hedgecrw/CivicAlert/README.md

# CivicAlert
Software, Firmware, and Hardware Design for the CivicAlert Gunshot Locator Project
