hedgecrw/CivicAlert/hardware/design/parts/CP2102N-A02-GQFN28/CP2102N-A02-GQFN28.step

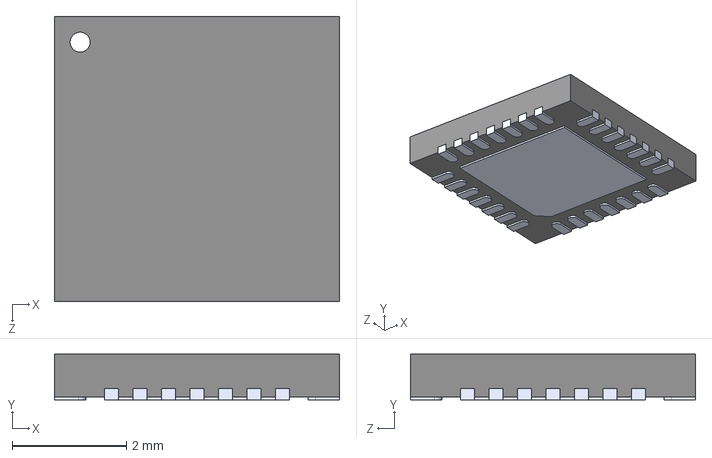
[picture p1: CAD file, 2025-01-08]
hardware/design/parts/CP2102N-A02-GQFN28/CP2102N-A02-GQFN28.step
5.00 x 0.8 x 5.00 mm
