hedgecrw/CivicAlert/hardware/design/parts/ESP32_S3_MINI_1_N8/ESP32-S3-MINI-1-N8.step

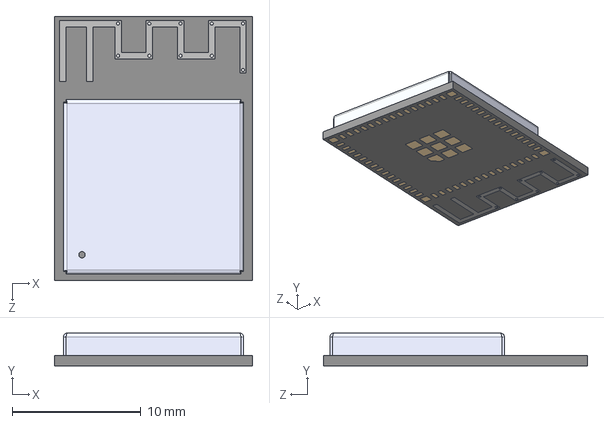
[picture p2: CAD file, 2025-01-08]
hardware/design/parts/ESP32_S3_MINI_1_N8/ESP32-S3-MINI-1-N8.step
15.4 x 2.55 x 20.5 mm
