hedgecrw/CivicAlert/hardware/design/parts/IM73D122V01XTMA1/3D/IM73D122V01XTMA1.stp

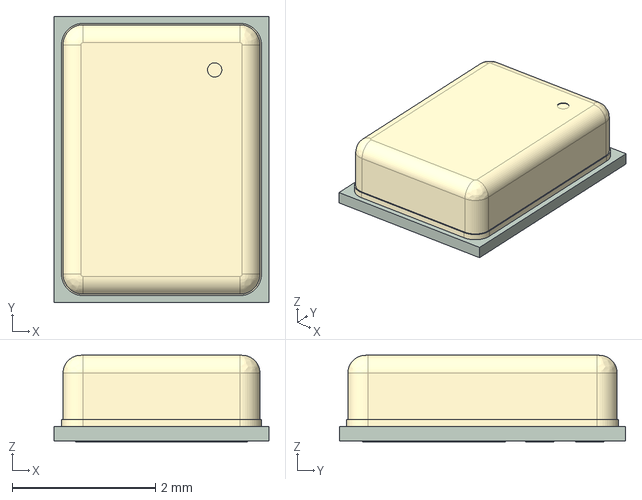
[picture p3: CAD file, 2025-01-08]
hardware/design/parts/IM73D122V01XTMA1/3D/IM73D122V01XTMA1.stp
3.00 x 4.00 x 1.21 mm
