hedgecrw/CivicAlert/hardware/design/parts/LQG15HS47NJ02D/LQG15HS47NJ02D.step

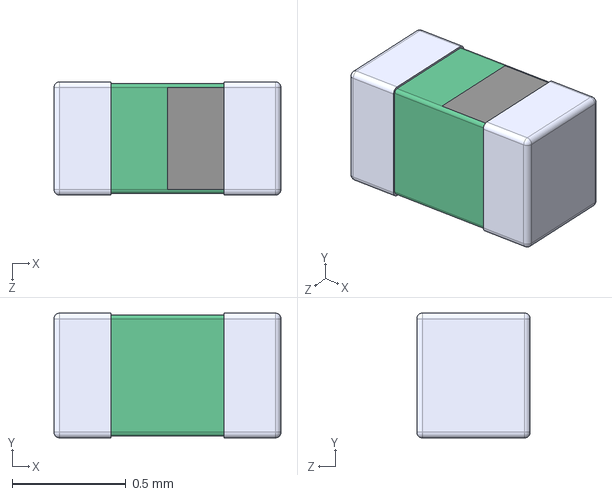
[picture p4: CAD file, 2025-01-08]
hardware/design/parts/LQG15HS47NJ02D/LQG15HS47NJ02D.step
1.00 x 0.55 x 0.5 mm
