hedgecrw/CivicAlert/hardware/design/parts/LTST-C170KRKT/LTST-C170KRKT.step

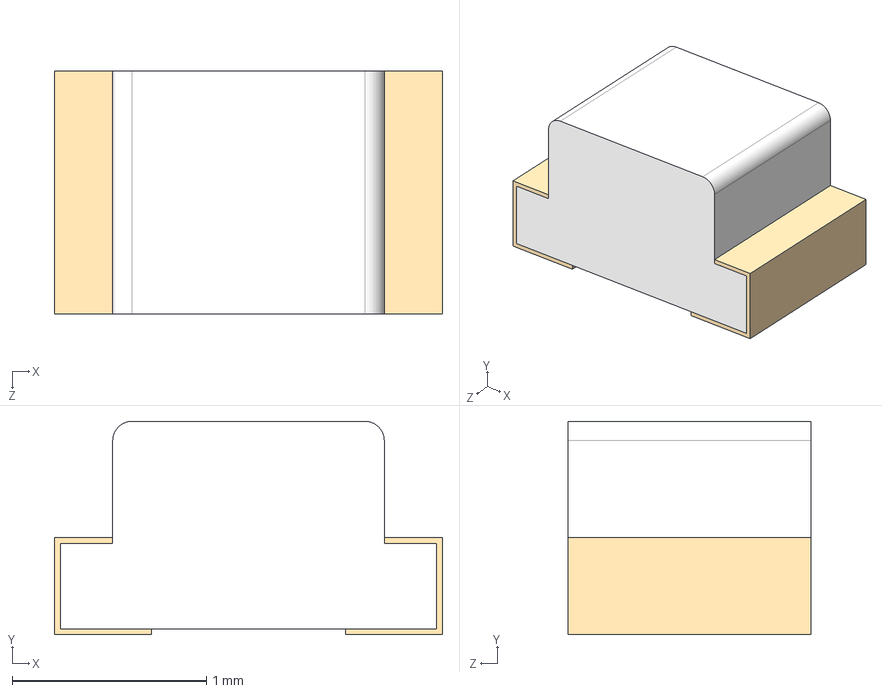
[picture p5: CAD file, 2025-01-08]
hardware/design/parts/LTST-C170KRKT/LTST-C170KRKT.step
2.00 x 1.10 x 1.25 mm
