hedgecrw/CivicAlert/hardware/design/parts/usb/1054440001.step

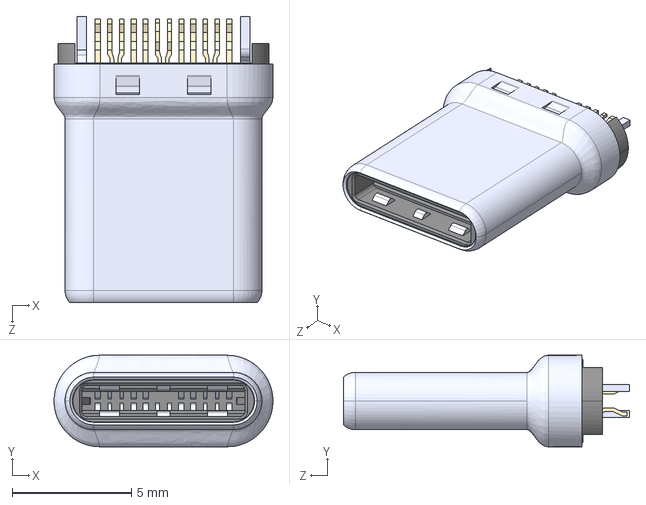
[picture p6: CAD file, 2025-01-08]
hardware/design/parts/usb/1054440001.step
9.18 x 3.84 x 12.0 mm
