hedgecrw/CivicAlert/hardware/design/CivicAlert.kicad_pcb

## KiCad design hardware/design/CivicAlert.kicad_pcb (2025-01-08)

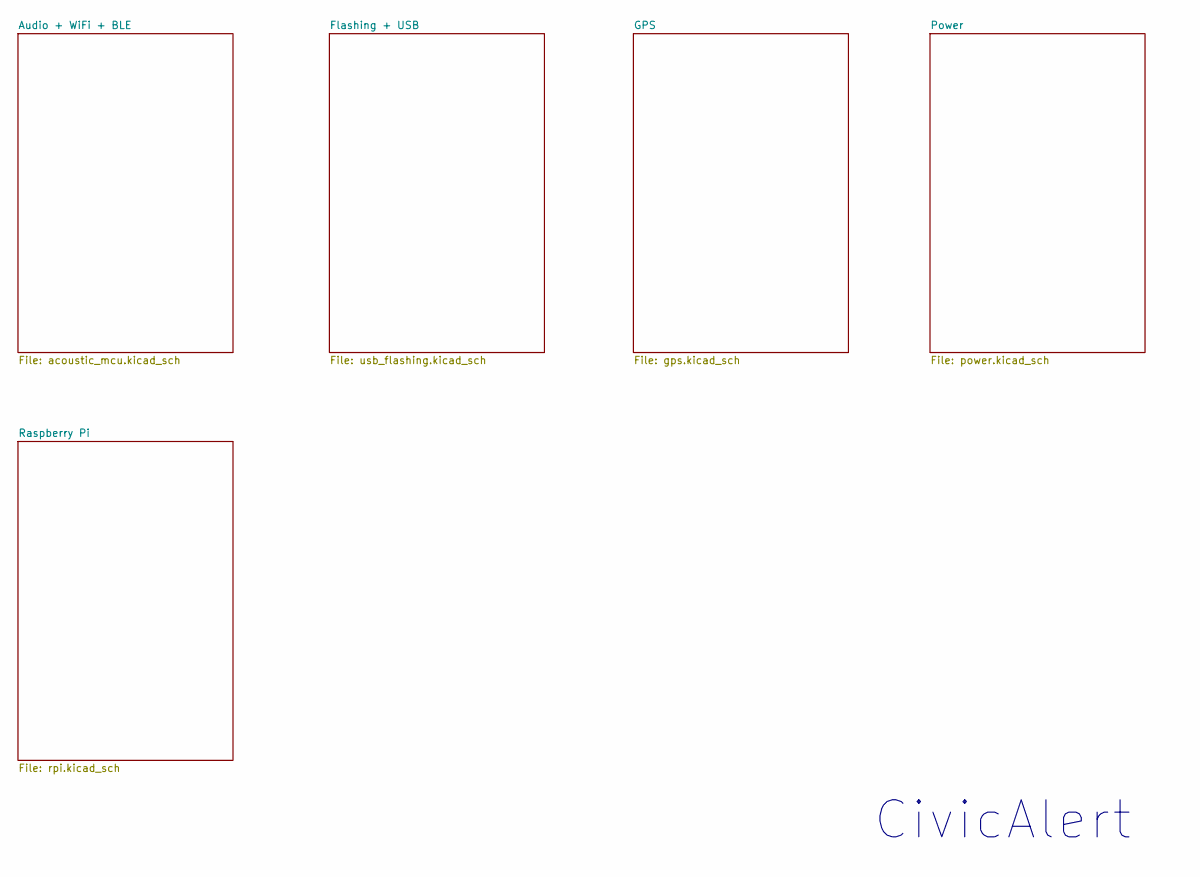
[picture p7: schematic CivicAlert.kicad_sch]

Notes on the sheet:
CivicAlert

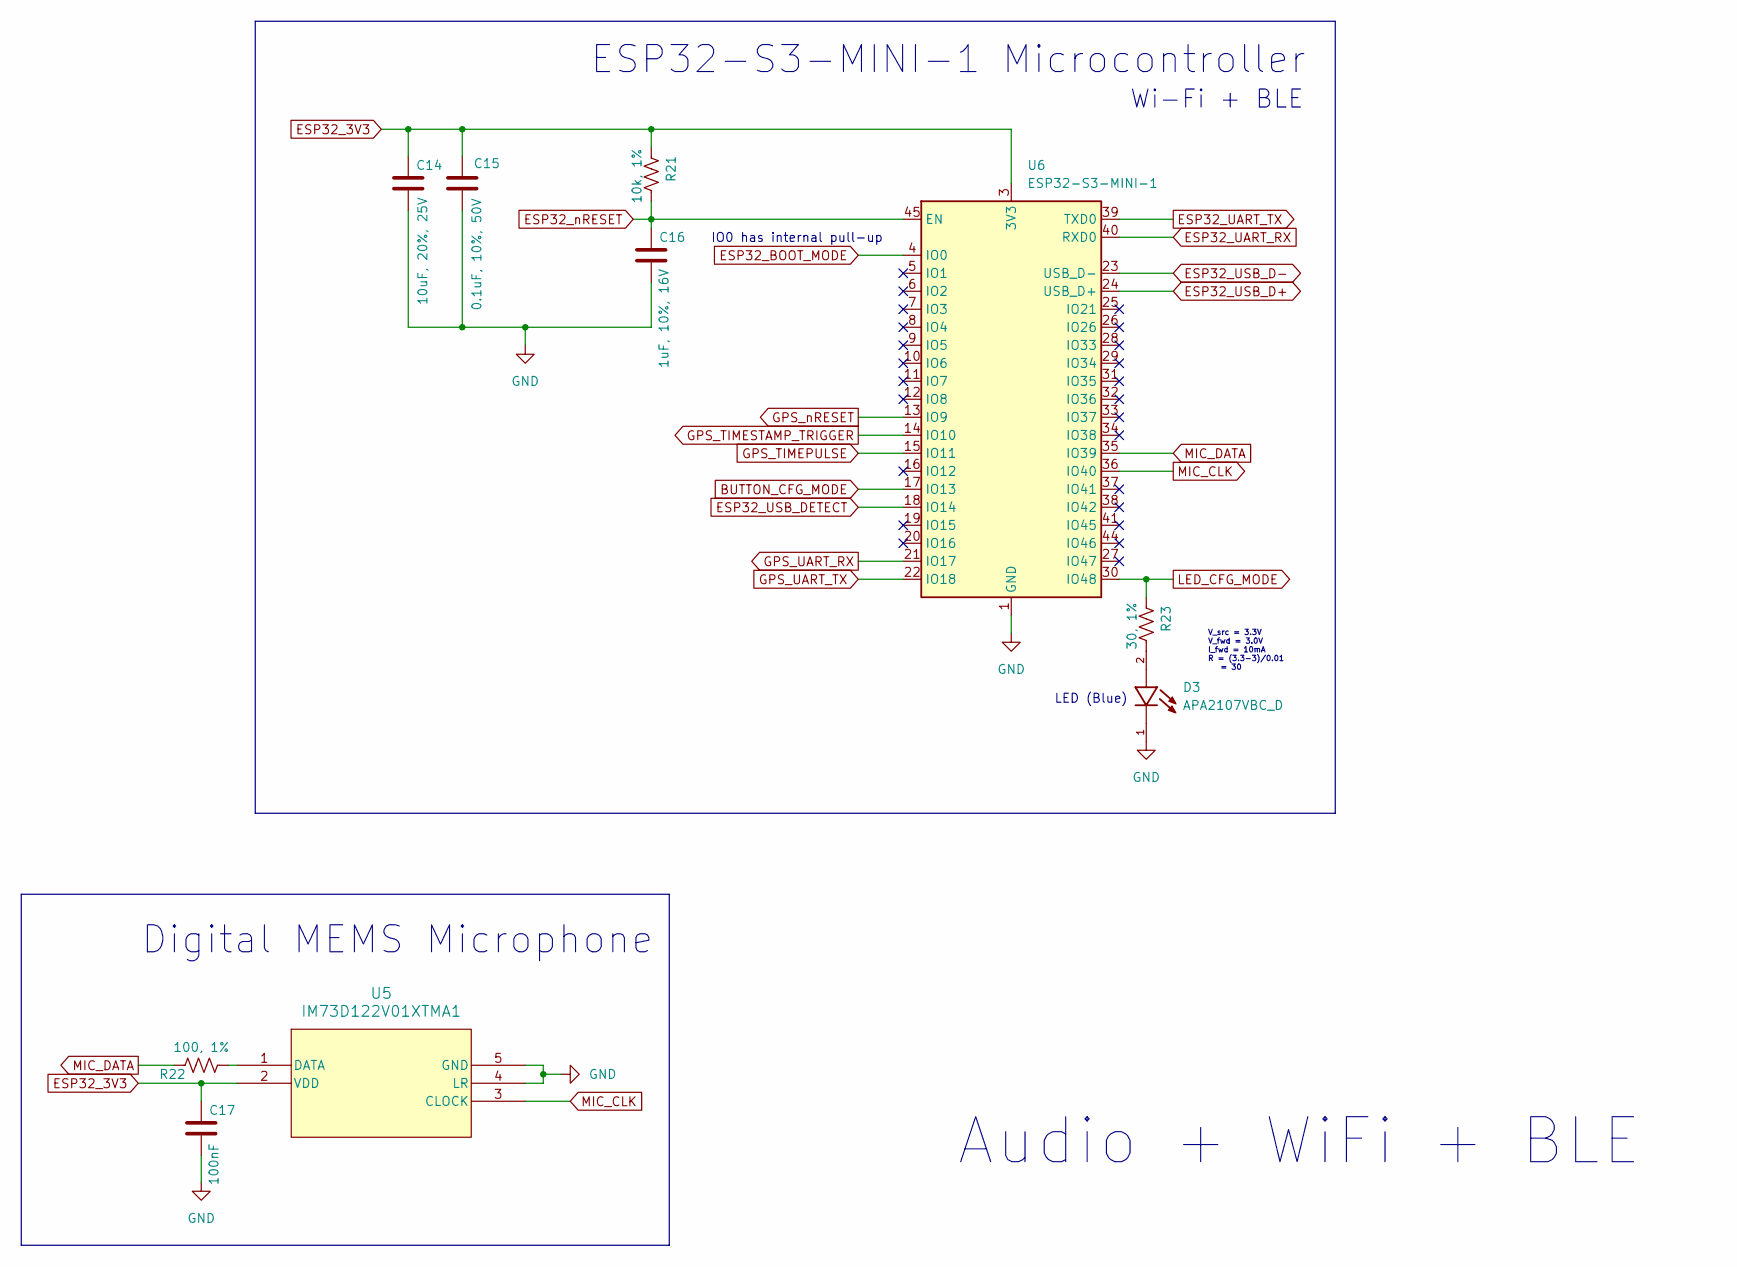
[picture p8: schematic acoustic_mcu.kicad_sch, CivicAlert]

Parts:
C14: 10uF, 20%, 25V; C_0805_2012Metric
C15: 0.1uF, 10%, 50V; C_0805_2012Metric
C16: 1uF, 10%, 16V; C_0805_2012Metric
C17: 100nF; C_0805_2012Metric
D3: APA2107VBC_D; LED_APA2107VBC_D; PARTREV V.5B
R21: 10k, 1%; R_0805_2012Metric
R22: 100, 1%; R_0805_2012Metric
R23: 30, 1%; R_0805_2012Metric
U5: IM73D122V01XTMA1; PG-LLGA-5-2_INF
U6: ESP32-S3-MINI-1; ESP32-S2-MINI-1

Connections:
BUTTON_CFG_MODE: U6.17 (IO13); also elsewhere on the board
ESP32_3V3: C14.1, C15.1, C17.1, R21.1, U5.2 (VDD), U6.3 (3V3); also elsewhere on the board
ESP32_BOOT_MODE: U6.4 (IO0); also elsewhere on the board
ESP32_UART_RX: U6.40 (RXD0); also elsewhere on the board
ESP32_UART_TX: U6.39 (TXD0); also elsewhere on the board
ESP32_USB_D+: U6.24 (USB_D+); also elsewhere on the board
ESP32_USB_D-: U6.23 (USB_D-); also elsewhere on the board
ESP32_USB_DETECT: U6.18 (IO14); also elsewhere on the board
ESP32_nRESET: C16.1, R21.2, U6.45 (EN); also elsewhere on the board
GND: C14.2, C15.2, C16.2, C17.2, D3.1, U5.4 (LR), U5.5 (GND), U6.1 (GND), U6.2 (GND), U6.42 (GND), U6.43 (GND), U6.46 (GND), U6.47 (GND), U6.48 (GND), U6.49 (GND), U6.50 (GND), U6.51 (GND), U6.52 (GND), U6.53 (GND), U6.54 (GND), U6.55 (GND), U6.56 (GND), U6.57 (GND), U6.58 (GND), U6.59 (GND), U6.60 (GND), U6.61 (GND), U6.62 (GND), U6.63 (GND), U6.64 (GND), U6.65 (GND); also elsewhere on the board
GPS_TIMEPULSE: U6.15 (IO11); also elsewhere on the board
GPS_TIMESTAMP_TRIGGER: U6.14 (IO10); also elsewhere on the board
GPS_UART_RX: U6.21 (IO17); also elsewhere on the board
GPS_UART_TX: U6.22 (IO18); also elsewhere on the board
GPS_nRESET: U6.13 (IO9); also elsewhere on the board
LED_CFG_MODE: R23.1, U6.30 (IO48)
MIC_CLK: U5.3 (CLOCK), U6.36 (IO40)
MIC_DATA: R22.2, U6.35 (IO39)
unnamed: D3.2, R23.2
unnamed: R22.1, U5.1 (DATA)

Notes on the sheet:
Digital MEMS Microphone
Audio + WiFi + BLE
ESP32-S3-MINI-1 Microcontroller
Wi-Fi + BLE
LED (Blue)
V_src = 3.3V V_fwd = 3.0V I_fwd = 10mA R = (3.3-3)/0.01 = 30
IO0 has internal pull-up

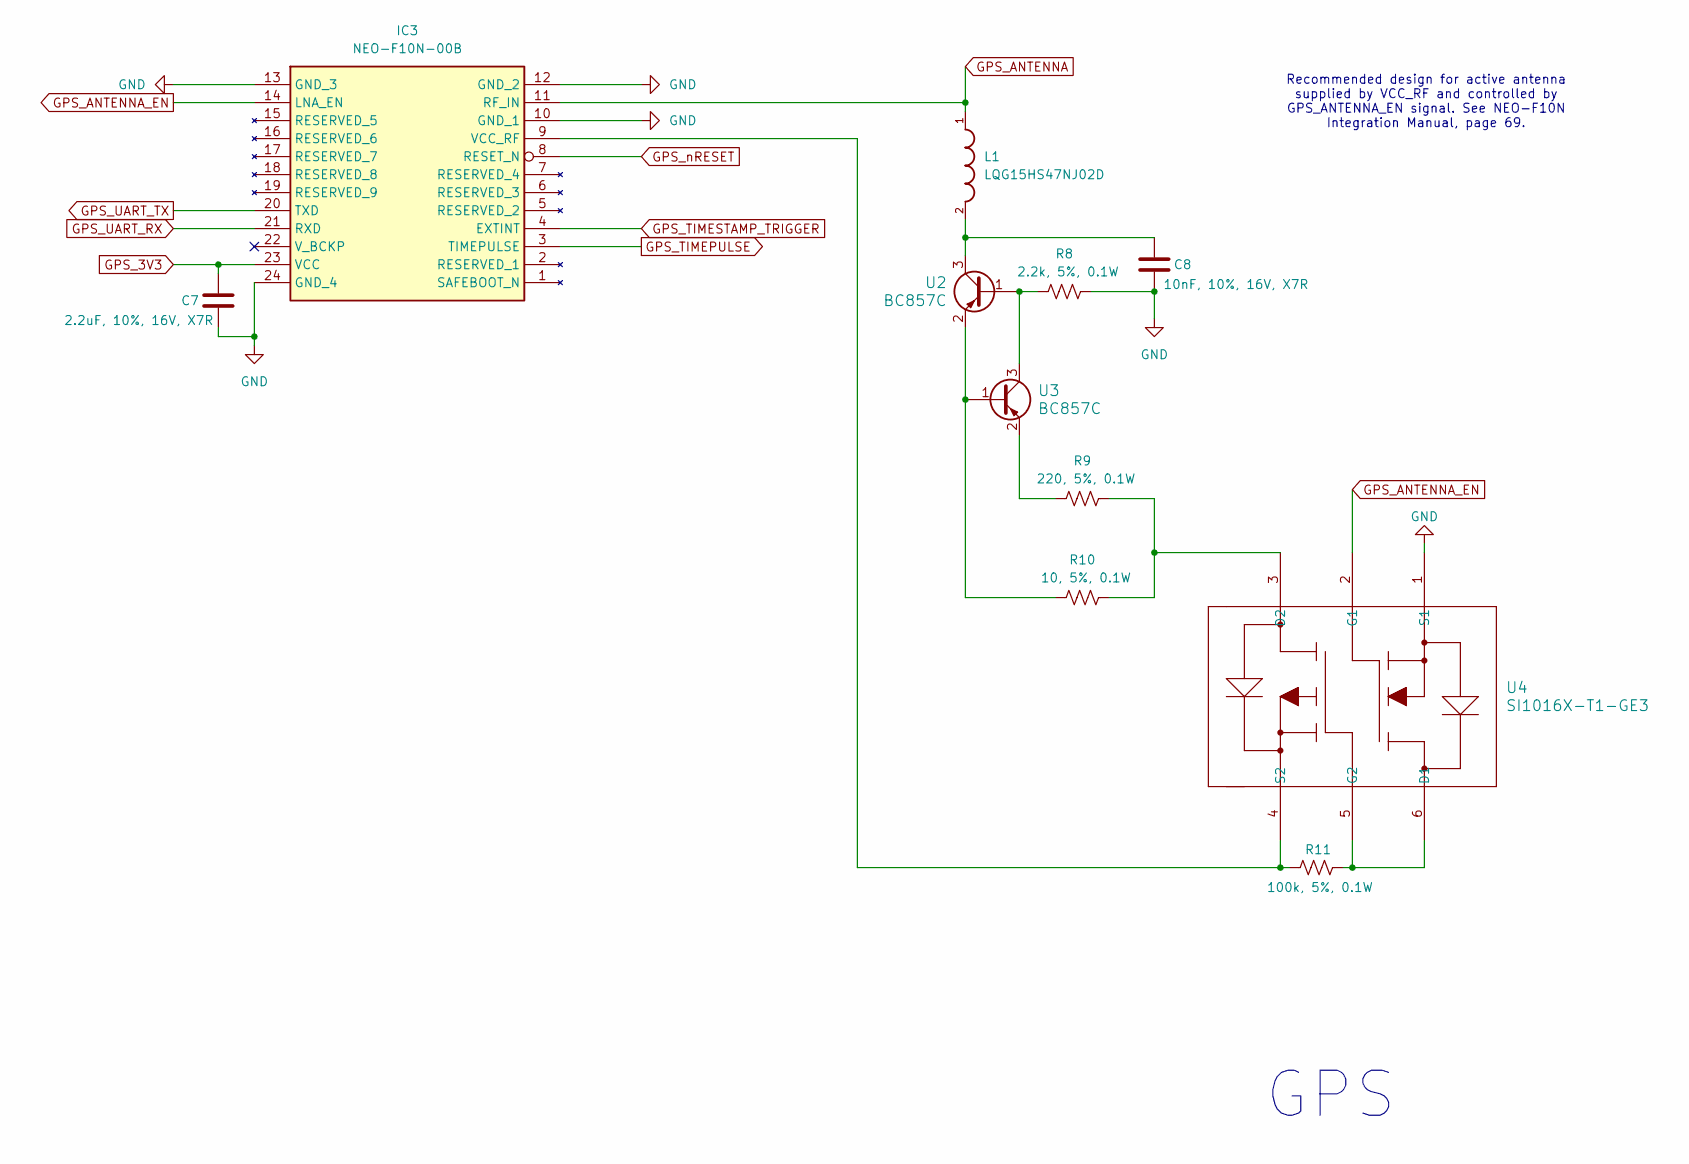
[picture p9: schematic gps.kicad_sch, CivicAlert]

Parts:
C7: 2.2uF, 10%, 16V, X7R; C_0805_2012Metric
C8: 10nF, 10%, 16V, X7R; C_0805_2012Metric
IC3: NEO-F10N-00B; NEOF10N00B; Mouser Part Number 377-NEO-F10N-00B
L1: LQG15HS47NJ02D; INDC1005X55N
R8: 2.2k, 5%, 0.1W; R_0805_2012Metric
R9: 220, 5%, 0.1W; R_0805_2012Metric
R10: 10, 5%, 0.1W; R_0805_2012Metric
R11: 100k, 5%, 0.1W; R_0805_2012Metric
U2, U3: BC857C; SOT-23
U4: SI1016X-T1-GE3; SOT_X-T1-GE3_VIS

Connections:
GND: C7.2, C8.2, IC3.10 (GND_1), IC3.12 (GND_2), IC3.13 (GND_3), IC3.24 (GND_4), R8.1, U4.1 (S1); also elsewhere on the board
GPS_3V3: C7.1, IC3.23 (VCC); also elsewhere on the board
GPS_ANTENNA: IC3.11 (RF_IN), L1.1
GPS_ANTENNA_EN: IC3.14 (LNA_EN), U4.2 (G1)
GPS_TIMEPULSE: IC3.3 (TIMEPULSE); also elsewhere on the board
GPS_TIMESTAMP_TRIGGER: IC3.4 (EXTINT); also elsewhere on the board
GPS_UART_RX: IC3.21 (RXD); also elsewhere on the board
GPS_UART_TX: IC3.20 (TXD); also elsewhere on the board
GPS_nRESET: IC3.8 (RESET_N); also elsewhere on the board
unnamed: IC3.9 (VCC_RF), R11.2, U4.4 (S2)
unnamed: R8.2, U2.1 (B), U3.3 (C)
unnamed: C8.1, L1.2, U2.3 (C)
unnamed: R10.2, U2.2 (E), U3.1 (B)
unnamed: R9.2, U3.2 (E)
unnamed: R11.1, U4.5 (G2), U4.6 (D1)
unnamed: R9.1, R10.1, U4.3 (D2)

Notes on the sheet:
GPS
Recommended design for active antenna supplied by VCC_RF and controlled by GPS_ANTENNA_EN signal. See NEO-F10N Integration Manual, page 69.

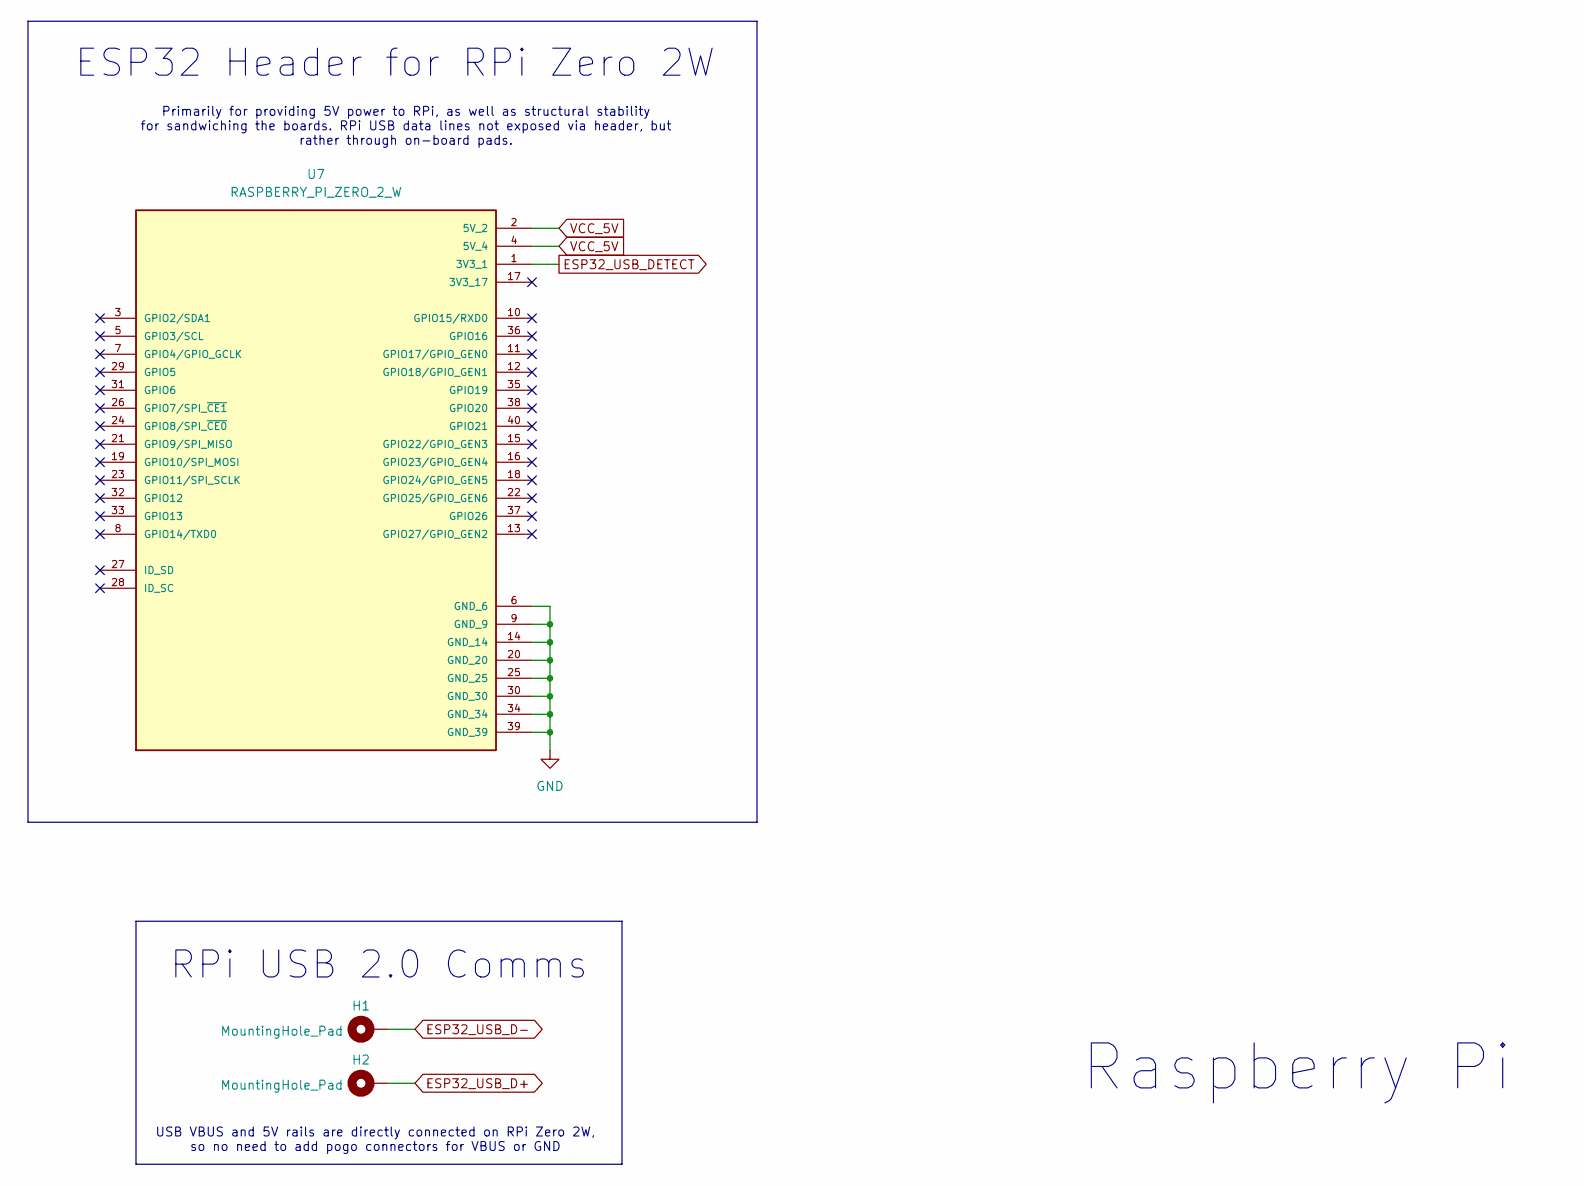
[picture p10: schematic rpi.kicad_sch, CivicAlert]

Parts:
H1, H2: MountingHole_Pad; PinHeader_1x01_P2.00mm_Vertical
U7: RASPBERRY_PI_ZERO_2_W; Raspberry Pi Zero 2W Header; PARTREV April 2024

Connections:
ESP32_USB_D+: H2.1; also elsewhere on the board
ESP32_USB_D-: H1.1; also elsewhere on the board
ESP32_USB_DETECT: U7.1 (3V3); also elsewhere on the board
GND: U7.6 (GND), U7.9 (GND), U7.14 (GND), U7.20 (GND), U7.25 (GND), U7.30 (GND), U7.34 (GND), U7.39 (GND); also elsewhere on the board
VCC_5V: U7.2 (5V), U7.4 (5V); also elsewhere on the board

Notes on the sheet:
Primarily for providing 5V power to RPi, as well as structural stability for sandwiching the boards. RPi USB data lines not exposed via header, but rather through on-board pads.
RPi USB 2.0 Comms
USB VBUS and 5V rails are directly connected on RPi Zero 2W, so no need to add pogo connectors for VBUS or GND
Raspberry Pi
ESP32 Header for RPi Zero 2W

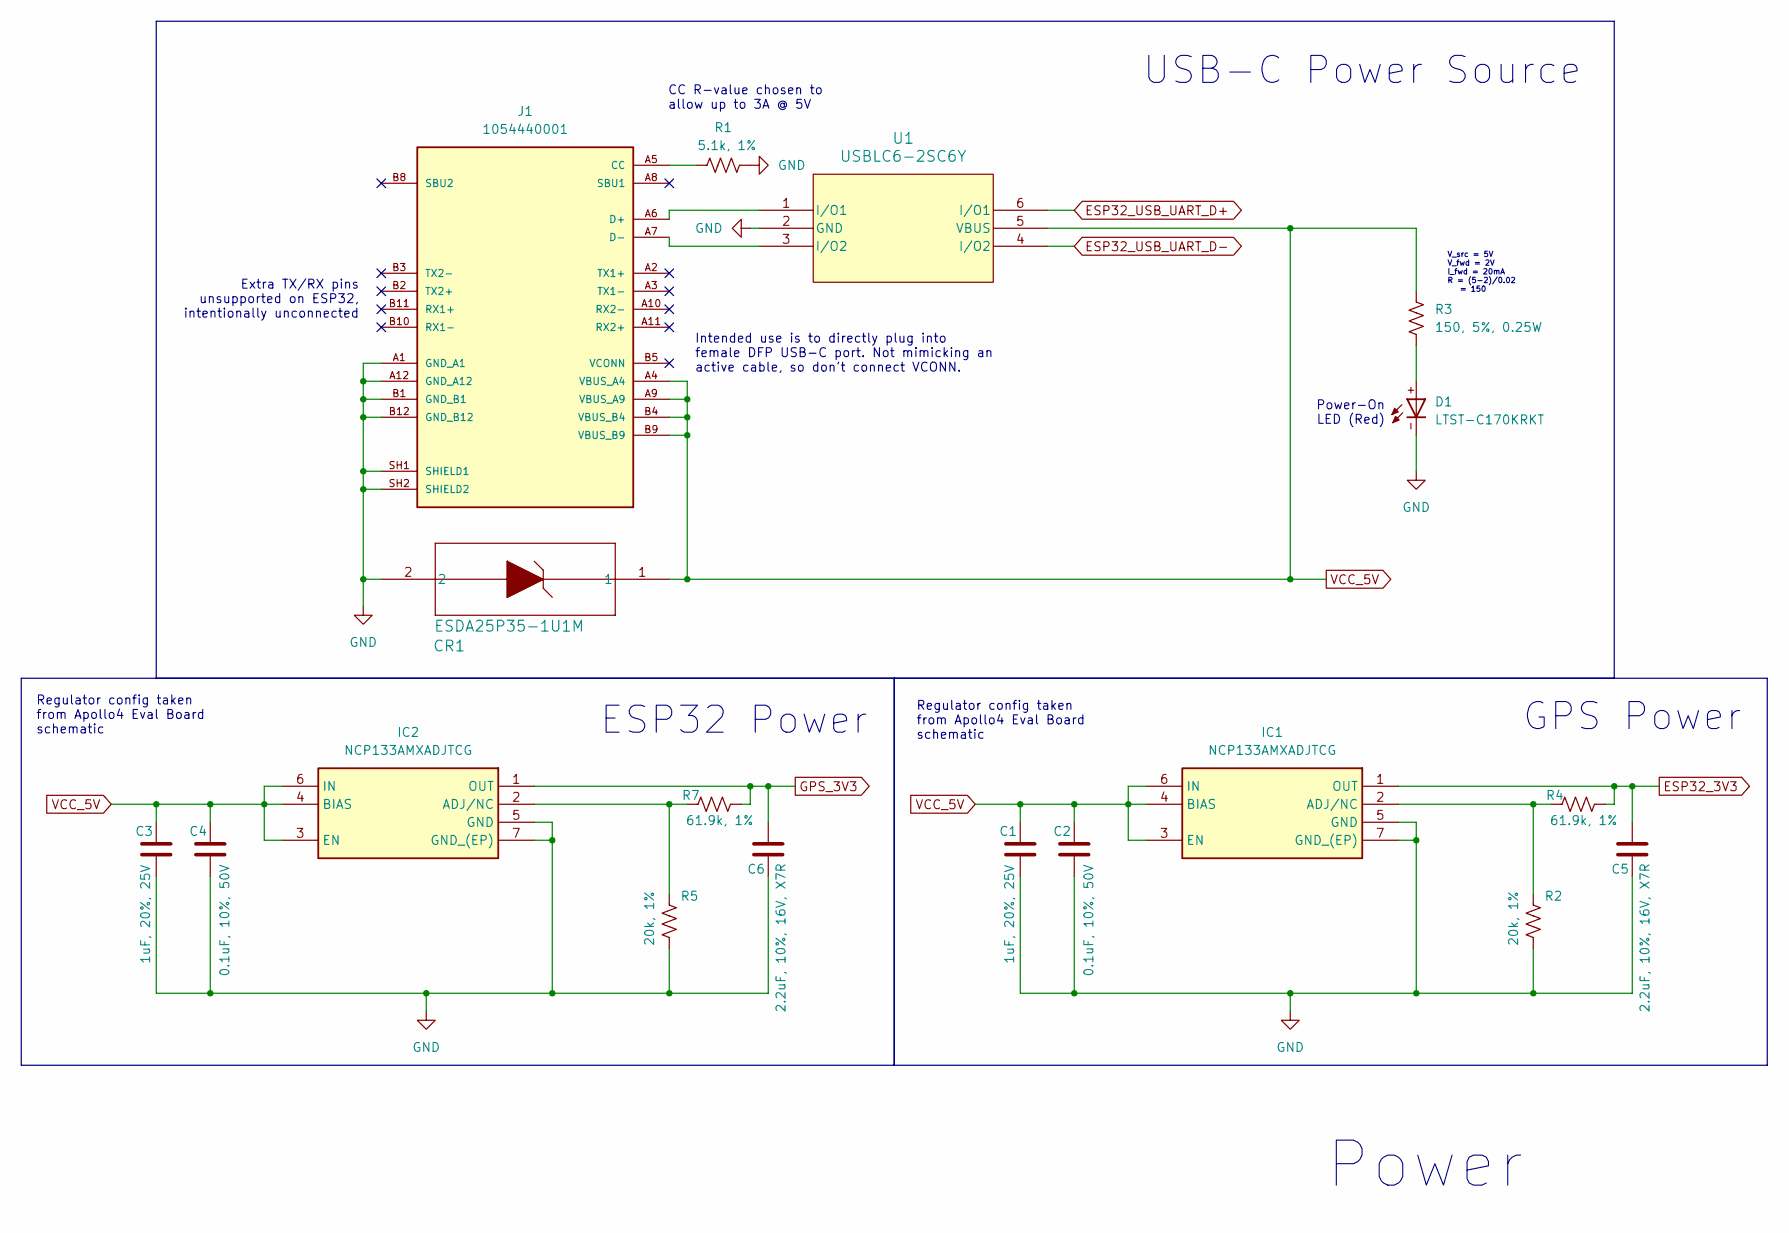
[picture p11: schematic power.kicad_sch, CivicAlert]

Parts:
C1, C3: 1uF, 20%, 25V; C_0805_2012Metric
C2, C4: 0.1uF, 10%, 50V; C_0805_2012Metric
C5, C6: 2.2uF, 10%, 16V, X7R; C_0805_2012Metric
CR1: ESDA25P35-1U1M; QFN1610_STM
D1: LTST-C170KRKT; DIOC200X125X110; DigiKey_Part_Number 160-1415-2-ND
IC1, IC2: NCP133AMXADJTCG; NCP133AMX110TCG; Mouser Part Number 863-NCP133AMXADJTCG
J1: 1054440001; MOLEX_1054440001; PARTREV C2; DigiKey_Part_Number WM12855-ND
R1: 5.1k, 1%; R_0805_2012Metric
R2, R5: 20k, 1%; R_0805_2012Metric
R3: 150, 5%, 0.25W; R_1206_3216Metric
R4, R7: 61.9k, 1%; R_0805_2012Metric
U1: USBLC6-2SC6Y; SOT23-6L_STM

Connections:
ESP32_3V3: C5.1, IC1.1 (OUT), R4.1; also elsewhere on the board
ESP32_USB_UART_D+: U1.6 (I/O1); also elsewhere on the board
ESP32_USB_UART_D-: U1.4 (I/O2); also elsewhere on the board
GND: C1.2, C2.2, C3.2, C4.2, C5.2, C6.2, CR1.2, D1.-, IC1.5 (GND), IC1.7 (GND_(EP)), IC2.5 (GND), IC2.7 (GND_(EP)), J1.A1 (GND_A1), J1.A12 (GND_A12), J1.B1 (GND_B1), J1.B12 (GND_B12), J1.SH1 (SHIELD1), J1.SH2 (SHIELD2), R1.1, R2.2, R5.2, U1.2 (GND); also elsewhere on the board
GPS_3V3: C6.1, IC2.1 (OUT), R7.1; also elsewhere on the board
unnamed: D1.+, R3.2
unnamed: IC1.2 (ADJ/NC), R2.1, R4.2
unnamed: IC2.2 (ADJ/NC), R5.1, R7.2
unnamed: J1.A5 (CC), R1.2
unnamed: J1.A6 (D+), U1.1 (I/O1)
unnamed: J1.A7 (D-), U1.3 (I/O2)
VCC_5V: C1.1, C2.1, C3.1, C4.1, CR1.1, IC1.3 (EN), IC1.4 (BIAS), IC1.6 (IN), IC2.3 (EN), IC2.4 (BIAS), IC2.6 (IN), J1.A4 (VBUS_A4), J1.A9 (VBUS_A9), J1.B4 (VBUS_B4), J1.B9 (VBUS_B9), R3.1, U1.5 (VBUS); also elsewhere on the board

Notes on the sheet:
Intended use is to directly plug into female DFP USB-C port. Not mimicking an active cable, so don't connect VCONN.
Regulator config taken from Apollo4 Eval Board schematic
Power
CC R-value chosen to allow up to 3A @ 5V
GPS Power
ESP32 Power
V_src = 5V V_fwd = 2V I_fwd = 20mA R = (5-2)/0.02 = 150
Extra TX/RX pins unsupported on ESP32, intentionally unconnected
USB-C Power Source
Power-On LED (Red)

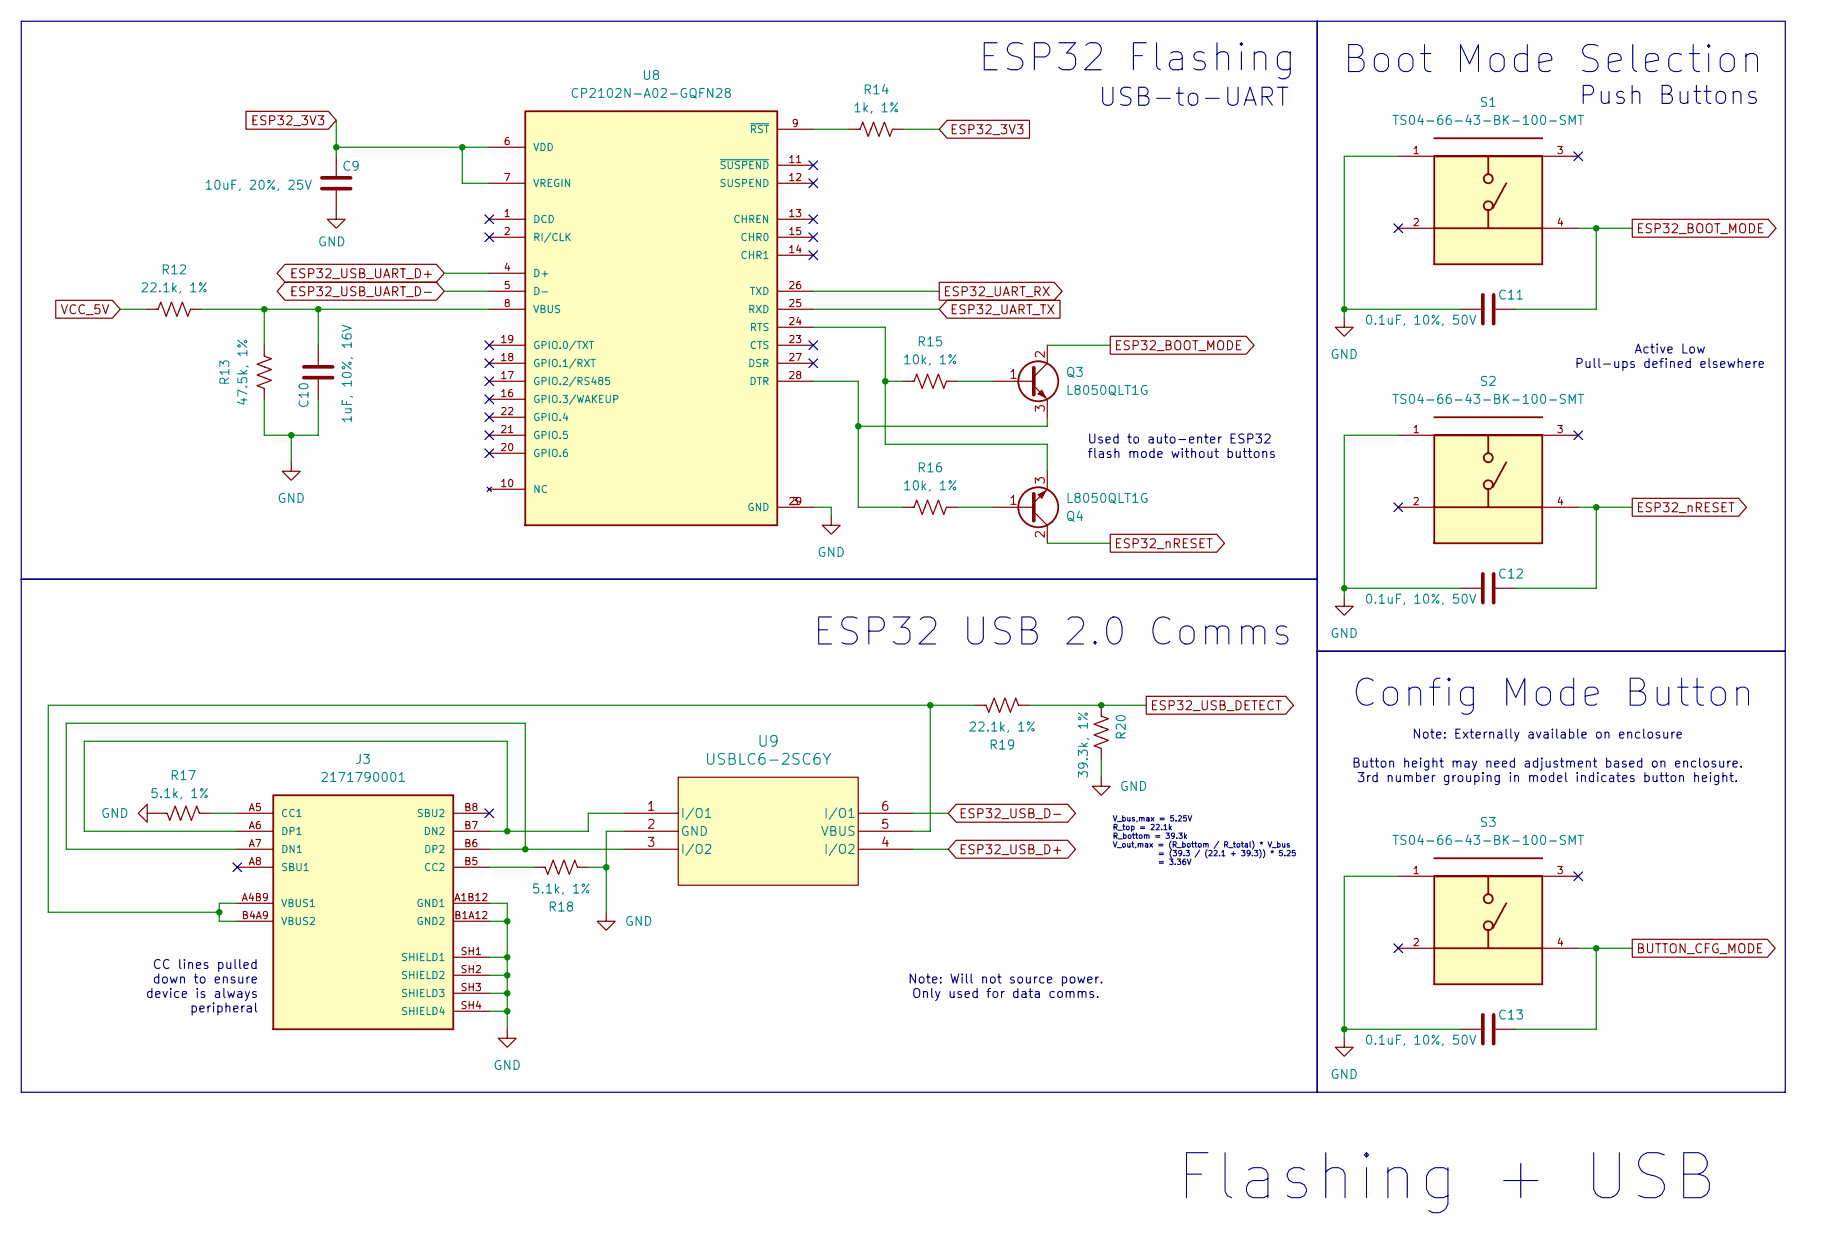
[picture p12: schematic usb_flashing.kicad_sch, CivicAlert]

Parts:
C9: 10uF, 20%, 25V; C_0805_2012Metric
C10: 1uF, 10%, 16V; C_0805_2012Metric
C11, C12, C13: 0.1uF, 10%, 50V; C_0805_2012Metric
J3: 2171790001; MOLEX_2171790001; PARTREV A1; DigiKey_Part_Number 900-2171790001TR-ND
Q3, Q4: L8050QLT1G
R12, R19: 22.1k, 1%; R_0805_2012Metric
R13: 47.5k, 1%; R_0805_2012Metric
R14: 1k, 1%; R_0805_2012Metric
R15, R16: 10k, 1%; R_0805_2012Metric
R17, R18: 5.1k, 1%; R_0805_2012Metric
R20: 39.3k, 1%; R_0805_2012Metric
S1, S2, S3: TS04-66-43-BK-100-SMT; SW_TS04-66-43-BK-100-SMT; PARTREV 1.0
U8: CP2102N-A02-GQFN28; QFN50P500X500X80-29N; PARTREV 1.5; DigiKey_Part_Number 336-5889-ND
U9: USBLC6-2SC6Y; SOT23-6L_STM

Connections:
BUTTON_CFG_MODE: C13.1, S3.4; also elsewhere on the board
ESP32_3V3: C9.1, R14.1, U8.6 (VDD), U8.7 (VREGIN); also elsewhere on the board
ESP32_BOOT_MODE: C11.1, Q3.2 (C), S1.4; also elsewhere on the board
ESP32_UART_RX: U8.26 (TXD); also elsewhere on the board
ESP32_UART_TX: U8.25 (RXD); also elsewhere on the board
ESP32_USB_D+: U9.4 (I/O2); also elsewhere on the board
ESP32_USB_D-: U9.6 (I/O1); also elsewhere on the board
ESP32_USB_DETECT: R19.1, R20.1; also elsewhere on the board
ESP32_USB_UART_D+: U8.4 (D+); also elsewhere on the board
ESP32_USB_UART_D-: U8.5 (D-); also elsewhere on the board
ESP32_nRESET: C12.1, Q4.2 (C), S2.4; also elsewhere on the board
GND: C9.2, C10.1, C11.2, C12.2, C13.2, J3.A1B12 (GND1), J3.B1A12 (GND2), J3.SH1 (SHIELD1), J3.SH2 (SHIELD2), J3.SH3 (SHIELD3), J3.SH4 (SHIELD4), R13.2, R17.1, R18.1, R20.2, S1.1, S2.1, S3.1, U8.3 (GND), U8.29 (GND), U9.2 (GND); also elsewhere on the board
unnamed: J3.A5 (CC1), R17.2
unnamed: J3.B5 (CC2), R18.2
unnamed: J3.A7 (DN1), J3.B6 (DP2), U9.3 (I/O2)
unnamed: J3.A6 (DP1), J3.B7 (DN2), U9.1 (I/O1)
unnamed: J3.A4B9 (VBUS1), J3.B4A9 (VBUS2), R19.2, U9.5 (VBUS)
unnamed: Q3.1 (B), R15.1
unnamed: Q3.3 (E), R16.2, U8.28 (DTR)
unnamed: Q4.1 (B), R16.1
unnamed: Q4.3 (E), R15.2, U8.24 (RTS)
unnamed: C10.2, R12.1, R13.1, U8.8 (VBUS)
unnamed: R14.2, U8.9 (~RST)
VCC_5V: R12.2; also elsewhere on the board

Notes on the sheet:
Active Low Pull-ups defined elsewhere
CC lines pulled down to ensure device is always peripheral
Note: Will not source power. Only used for data comms.
V_bus,max = 5.25V R_top = 22.1k R_bottom = 39.3k V_out,max = (R_bottom / R_total) * V_bus = (39.3 / (22.1 + 39.3)) * 5.25 = 3.36V
Note: Externally available on enclosure Button height may need adjustment based on enclosure. 3rd number grouping in model indicates button height.
Push Buttons
Flashing + USB
Used to auto-enter ESP32 flash mode without buttons
USB-to-UART
Boot Mode Selection
Config Mode Button
ESP32 Flashing
ESP32 USB 2.0 Comms

Board: 4 copper layers, 68 parts (0 on the bottom side), 50 nets, no tracks yet.

Other parts of the board:
MountingHole: MountingHole_2.7mm
MountingHole#2, MountingHole#3, MountingHole#4: MountingHole_2.7mm
